SultanShadow/Bi_DIR_AMP_5G/netgen/user_analog_project_wrapper.spice

* NGSPICE file created from user_analog_project_wrapper.ext - technology: sky130A

.subckt sky130_fd_pr__pfet_01v8_lvt_4QC8GG a_n93_n5000# w_n231_n5219# a_n35_n5097#
+ a_35_n5000# VSUBS
X0 a_35_n5000# a_n35_n5097# a_n93_n5000# w_n231_n5219# sky130_fd_pr__pfet_01v8_lvt ad=0p pd=0u as=0p ps=0u w=5e+07u l=350000u
.ends

.subckt sky130_fd_pr__nfet_01v8_lvt_8K7EBA a_n93_n2000# w_n221_n2200# a_35_n2000#
+ a_n35_n2088#
X0 a_35_n2000# a_n35_n2088# a_n93_n2000# w_n221_n2200# sky130_fd_pr__nfet_01v8_lvt ad=0p pd=0u as=0p ps=0u w=2e+07u l=350000u
.ends

.subckt Comparator_jafar VIN- VOUT VSS VINp
Xsky130_fd_pr__pfet_01v8_lvt_4QC8GG_0 VIN- VIN- a_3872_2262# m1_7222_1296# VSS sky130_fd_pr__pfet_01v8_lvt_4QC8GG
Xsky130_fd_pr__pfet_01v8_lvt_4QC8GG_1 VIN- VIN- m1_7222_1296# a_3872_2262# VSS sky130_fd_pr__pfet_01v8_lvt_4QC8GG
Xsky130_fd_pr__pfet_01v8_lvt_4QC8GG_2 VOUT VIN- m1_7222_1296# VINp VSS sky130_fd_pr__pfet_01v8_lvt_4QC8GG
Xsky130_fd_pr__nfet_01v8_lvt_8K7EBA_0 m1_6338_1372# VSS VSS VIN- sky130_fd_pr__nfet_01v8_lvt_8K7EBA
Xsky130_fd_pr__nfet_01v8_lvt_8K7EBA_1 m1_6338_1372# VSS m1_7222_1296# VINp sky130_fd_pr__nfet_01v8_lvt_8K7EBA
Xsky130_fd_pr__nfet_01v8_lvt_8K7EBA_2 a_3872_2262# VSS m1_6338_1372# VIN- sky130_fd_pr__nfet_01v8_lvt_8K7EBA
Xsky130_fd_pr__nfet_01v8_lvt_8K7EBA_3 m1_10602_1432# VSS VOUT VINp sky130_fd_pr__nfet_01v8_lvt_8K7EBA
Xsky130_fd_pr__nfet_01v8_lvt_8K7EBA_4 m1_10602_1432# VSS VSS VIN- sky130_fd_pr__nfet_01v8_lvt_8K7EBA
.ends

.subckt sky130_fd_pr__cap_mim_m3_1_ZP6U3S c1_3269_n47100# c1_41183_n47100# m3_22126_n47200#
+ m3_n15788_n47200# m3_n34745_n47200# m3_n47383_n47200# m3_9488_n47200# c1_22226_n47100#
+ c1_n22007_n47100# c1_n40964_n47100# m3_n28426_n47200# m3_34764_n47200# c1_n9369_n47100#
+ c1_9588_n47100# m3_n41064_n47200# c1_n3050_n47100# m3_3169_n47200# c1_34864_n47100#
+ c1_n15688_n47100# c1_n34645_n47100# c1_n47283_n47100# m3_28445_n47200# m3_15807_n47200#
+ m3_n9469_n47200# m3_41083_n47200# m3_n22107_n47200# c1_28545_n47100# c1_15907_n47100#
+ c1_n28326_n47100# m3_n3150_n47200# VSUBS
X0 c1_n47283_n47100# m3_n47383_n47200# sky130_fd_pr__cap_mim_m3_1 l=3e+07u w=3e+07u
X1 c1_41183_n47100# m3_41083_n47200# sky130_fd_pr__cap_mim_m3_1 l=3e+07u w=3e+07u
X2 c1_n40964_n47100# m3_n41064_n47200# sky130_fd_pr__cap_mim_m3_1 l=3e+07u w=3e+07u
X3 c1_41183_n47100# m3_41083_n47200# sky130_fd_pr__cap_mim_m3_1 l=3e+07u w=3e+07u
X4 c1_28545_n47100# m3_28445_n47200# sky130_fd_pr__cap_mim_m3_1 l=3e+07u w=3e+07u
X5 c1_n22007_n47100# m3_n22107_n47200# sky130_fd_pr__cap_mim_m3_1 l=3e+07u w=3e+07u
X6 c1_34864_n47100# m3_34764_n47200# sky130_fd_pr__cap_mim_m3_1 l=3e+07u w=3e+07u
X7 c1_n40964_n47100# m3_n41064_n47200# sky130_fd_pr__cap_mim_m3_1 l=3e+07u w=3e+07u
X8 c1_n47283_n47100# m3_n47383_n47200# sky130_fd_pr__cap_mim_m3_1 l=3e+07u w=3e+07u
X9 c1_34864_n47100# m3_34764_n47200# sky130_fd_pr__cap_mim_m3_1 l=3e+07u w=3e+07u
X10 c1_n15688_n47100# m3_n15788_n47200# sky130_fd_pr__cap_mim_m3_1 l=3e+07u w=3e+07u
X11 c1_n34645_n47100# m3_n34745_n47200# sky130_fd_pr__cap_mim_m3_1 l=3e+07u w=3e+07u
X12 c1_15907_n47100# m3_15807_n47200# sky130_fd_pr__cap_mim_m3_1 l=3e+07u w=3e+07u
X13 c1_n15688_n47100# m3_n15788_n47200# sky130_fd_pr__cap_mim_m3_1 l=3e+07u w=3e+07u
X14 c1_n40964_n47100# m3_n41064_n47200# sky130_fd_pr__cap_mim_m3_1 l=3e+07u w=3e+07u
X15 c1_9588_n47100# m3_9488_n47200# sky130_fd_pr__cap_mim_m3_1 l=3e+07u w=3e+07u
X16 c1_n34645_n47100# m3_n34745_n47200# sky130_fd_pr__cap_mim_m3_1 l=3e+07u w=3e+07u
X17 c1_15907_n47100# m3_15807_n47200# sky130_fd_pr__cap_mim_m3_1 l=3e+07u w=3e+07u
X18 c1_34864_n47100# m3_34764_n47200# sky130_fd_pr__cap_mim_m3_1 l=3e+07u w=3e+07u
X19 c1_n3050_n47100# m3_n3150_n47200# sky130_fd_pr__cap_mim_m3_1 l=3e+07u w=3e+07u
X20 c1_n47283_n47100# m3_n47383_n47200# sky130_fd_pr__cap_mim_m3_1 l=3e+07u w=3e+07u
X21 c1_22226_n47100# m3_22126_n47200# sky130_fd_pr__cap_mim_m3_1 l=3e+07u w=3e+07u
X22 c1_41183_n47100# m3_41083_n47200# sky130_fd_pr__cap_mim_m3_1 l=3e+07u w=3e+07u
X23 c1_9588_n47100# m3_9488_n47200# sky130_fd_pr__cap_mim_m3_1 l=3e+07u w=3e+07u
X24 c1_n34645_n47100# m3_n34745_n47200# sky130_fd_pr__cap_mim_m3_1 l=3e+07u w=3e+07u
X25 c1_n15688_n47100# m3_n15788_n47200# sky130_fd_pr__cap_mim_m3_1 l=3e+07u w=3e+07u
X26 c1_28545_n47100# m3_28445_n47200# sky130_fd_pr__cap_mim_m3_1 l=3e+07u w=3e+07u
X27 c1_n34645_n47100# m3_n34745_n47200# sky130_fd_pr__cap_mim_m3_1 l=3e+07u w=3e+07u
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
Xsky130_fd_pr__pfet_01v8_lvt_4QDPGG_0[14] B G S D sky130_fd_pr__pfet_01v8_lvt_4QDPGG_0[14]/VSUBS
+ sky130_fd_pr__pfet_01v8_lvt_4QDPGG
Xsky130_fd_pr__pfet_01v8_lvt_4QDPGG_0[15] B G S D sky130_fd_pr__pfet_01v8_lvt_4QDPGG_0[15]/VSUBS
+ sky130_fd_pr__pfet_01v8_lvt_4QDPGG
Xsky130_fd_pr__pfet_01v8_lvt_4QDPGG_0[16] B G S D sky130_fd_pr__pfet_01v8_lvt_4QDPGG_0[16]/VSUBS
+ sky130_fd_pr__pfet_01v8_lvt_4QDPGG
Xsky130_fd_pr__pfet_01v8_lvt_4QDPGG_0[17] B G S D sky130_fd_pr__pfet_01v8_lvt_4QDPGG_0[17]/VSUBS
+ sky130_fd_pr__pfet_01v8_lvt_4QDPGG
Xsky130_fd_pr__pfet_01v8_lvt_4QDPGG_0[18] B G S D VSUBS sky130_fd_pr__pfet_01v8_lvt_4QDPGG
Xsky130_fd_pr__pfet_01v8_lvt_4QDPGG_0[19] B G S D sky130_fd_pr__pfet_01v8_lvt_4QDPGG_0[19]/VSUBS
+ sky130_fd_pr__pfet_01v8_lvt_4QDPGG
.ends

.subckt pmos40 pmos20_0[1]/S pmos20_0[1]/G pmos20_0[1]/B pmos20_0[1]/D VSUBS
Xpmos20_0[0] pmos20_0[1]/D pmos20_0[1]/S pmos20_0[1]/B pmos20_0[1]/G VSUBS pmos20
Xpmos20_0[1] pmos20_0[1]/D pmos20_0[1]/S pmos20_0[1]/B pmos20_0[1]/G pmos20_0[1]/VSUBS
+ pmos20
.ends

.subckt sky130_fd_pr__nfet_01v8_lvt_BPY4AF w_n221_n8200# a_35_n8000# a_n35_n8088#
+ a_n93_n8000#
X0 a_35_n8000# a_n35_n8088# a_n93_n8000# w_n221_n8200# sky130_fd_pr__nfet_01v8_lvt ad=0p pd=0u as=0p ps=0u w=8e+07u l=350000u
.ends

.subckt nmos20 B G D S VSUBS
Xsky130_fd_pr__nfet_01v8_lvt_BPY4AF_0[0] sky130_fd_pr__nfet_01v8_lvt_BPY4AF_0[0]/w_n221_n8200#
+ S G D sky130_fd_pr__nfet_01v8_lvt_BPY4AF
Xsky130_fd_pr__nfet_01v8_lvt_BPY4AF_0[1] sky130_fd_pr__nfet_01v8_lvt_BPY4AF_0[1]/w_n221_n8200#
+ S G D sky130_fd_pr__nfet_01v8_lvt_BPY4AF
Xsky130_fd_pr__nfet_01v8_lvt_BPY4AF_0[2] B S G D sky130_fd_pr__nfet_01v8_lvt_BPY4AF
Xsky130_fd_pr__nfet_01v8_lvt_BPY4AF_0[3] sky130_fd_pr__nfet_01v8_lvt_BPY4AF_0[3]/w_n221_n8200#
+ S G D sky130_fd_pr__nfet_01v8_lvt_BPY4AF
Xsky130_fd_pr__nfet_01v8_lvt_BPY4AF_0[4] sky130_fd_pr__nfet_01v8_lvt_BPY4AF_0[4]/w_n221_n8200#
+ S G D sky130_fd_pr__nfet_01v8_lvt_BPY4AF
Xsky130_fd_pr__nfet_01v8_lvt_BPY4AF_0[5] B S G D sky130_fd_pr__nfet_01v8_lvt_BPY4AF
Xsky130_fd_pr__nfet_01v8_lvt_BPY4AF_0[6] sky130_fd_pr__nfet_01v8_lvt_BPY4AF_0[6]/w_n221_n8200#
+ S G D sky130_fd_pr__nfet_01v8_lvt_BPY4AF
Xsky130_fd_pr__nfet_01v8_lvt_BPY4AF_0[7] sky130_fd_pr__nfet_01v8_lvt_BPY4AF_0[7]/w_n221_n8200#
+ S G D sky130_fd_pr__nfet_01v8_lvt_BPY4AF
Xsky130_fd_pr__nfet_01v8_lvt_BPY4AF_0[8] B S G D sky130_fd_pr__nfet_01v8_lvt_BPY4AF
Xsky130_fd_pr__nfet_01v8_lvt_BPY4AF_0[9] sky130_fd_pr__nfet_01v8_lvt_BPY4AF_0[9]/w_n221_n8200#
+ S G D sky130_fd_pr__nfet_01v8_lvt_BPY4AF
Xsky130_fd_pr__nfet_01v8_lvt_BPY4AF_0[10] sky130_fd_pr__nfet_01v8_lvt_BPY4AF_0[10]/w_n221_n8200#
+ S G D sky130_fd_pr__nfet_01v8_lvt_BPY4AF
Xsky130_fd_pr__nfet_01v8_lvt_BPY4AF_0[11] B S G D sky130_fd_pr__nfet_01v8_lvt_BPY4AF
Xsky130_fd_pr__nfet_01v8_lvt_BPY4AF_0[12] sky130_fd_pr__nfet_01v8_lvt_BPY4AF_0[12]/w_n221_n8200#
+ S G D sky130_fd_pr__nfet_01v8_lvt_BPY4AF
Xsky130_fd_pr__nfet_01v8_lvt_BPY4AF_0[13] sky130_fd_pr__nfet_01v8_lvt_BPY4AF_0[13]/w_n221_n8200#
+ S G D sky130_fd_pr__nfet_01v8_lvt_BPY4AF
Xsky130_fd_pr__nfet_01v8_lvt_BPY4AF_0[14] sky130_fd_pr__nfet_01v8_lvt_BPY4AF_0[14]/w_n221_n8200#
+ S G D sky130_fd_pr__nfet_01v8_lvt_BPY4AF
Xsky130_fd_pr__nfet_01v8_lvt_BPY4AF_0[15] B S G D sky130_fd_pr__nfet_01v8_lvt_BPY4AF
Xsky130_fd_pr__nfet_01v8_lvt_BPY4AF_0[16] sky130_fd_pr__nfet_01v8_lvt_BPY4AF_0[16]/w_n221_n8200#
+ S G D sky130_fd_pr__nfet_01v8_lvt_BPY4AF
Xsky130_fd_pr__nfet_01v8_lvt_BPY4AF_0[17] sky130_fd_pr__nfet_01v8_lvt_BPY4AF_0[17]/w_n221_n8200#
+ S G D sky130_fd_pr__nfet_01v8_lvt_BPY4AF
Xsky130_fd_pr__nfet_01v8_lvt_BPY4AF_0[18] B S G D sky130_fd_pr__nfet_01v8_lvt_BPY4AF
Xsky130_fd_pr__nfet_01v8_lvt_BPY4AF_0[19] B S G D sky130_fd_pr__nfet_01v8_lvt_BPY4AF
.ends

.subckt recitifer_layout VIN1 VSS VINN VINP VSUBS
Xpmos20_0 VIN1 VINP VINP VINN VSUBS pmos20
Xpmos20_1 VIN1 VINN VINN VINP VSUBS pmos20
Xnmos20_0 VSS VINP VINN VSS VSUBS nmos20
Xnmos20_1 VSS VINN VINP VSS VSUBS nmos20
.ends

.subckt RX_layout VOUT_C VSS VIN1 VIN2 pmos40_0/pmos20_0[1]/D recitifer_layout_0/VINP
+ recitifer_layout_0/VINN VSUBS
Xcap225_layout_0 VIN2 VSS VSUBS cap225_layout
Xpmos40_0 VIN2 VOUT_C VIN2 pmos40_0/pmos20_0[1]/D VSUBS pmos40
Xrecitifer_layout_0 VIN1 VSS recitifer_layout_0/VINN recitifer_layout_0/VINP VSUBS
+ recitifer_layout
Xpmos40_1 VIN1 VOUT_C VIN2 VIN2 VSUBS pmos40
.ends

.subckt FINAL RX_layout_0/recitifer_layout_0/VINP RX_layout_0/pmos40_0/pmos20_0[1]/D
+ RX_layout_0/recitifer_layout_0/VINN RX_layout_0/VIN2 VSUBS
XComparator_jafar_0 RX_layout_0/VIN1 RX_layout_0/VOUT_C VSUBS RX_layout_0/VIN2 Comparator_jafar
XRX_layout_0 RX_layout_0/VOUT_C VSUBS RX_layout_0/VIN1 RX_layout_0/VIN2 RX_layout_0/pmos40_0/pmos20_0[1]/D
+ RX_layout_0/recitifer_layout_0/VINP RX_layout_0/recitifer_layout_0/VINN VSUBS RX_layout
.ends

.subckt sky130_fd_pr__cap_mim_m3_1_LQCLLG m3_n12628_n12550# c1_110_n12450# c1_n6209_n12450#
+ m3_6329_n12550# c1_n12528_n12450# m3_10_n12550# c1_6429_n12450# m3_n6309_n12550#
+ VSUBS
X0 c1_6429_n12450# m3_6329_n12550# sky130_fd_pr__cap_mim_m3_1 l=3e+07u w=3e+07u
X1 c1_n6209_n12450# m3_n6309_n12550# sky130_fd_pr__cap_mim_m3_1 l=3e+07u w=3e+07u
X2 c1_110_n12450# m3_10_n12550# sky130_fd_pr__cap_mim_m3_1 l=3e+07u w=3e+07u
X3 c1_6429_n12450# m3_6329_n12550# sky130_fd_pr__cap_mim_m3_1 l=3e+07u w=3e+07u
X4 c1_110_n12450# m3_10_n12550# sky130_fd_pr__cap_mim_m3_1 l=3e+07u w=3e+07u
X5 c1_n12528_n12450# m3_n12628_n12550# sky130_fd_pr__cap_mim_m3_1 l=3e+07u w=3e+07u
X6 c1_n6209_n12450# m3_n6309_n12550# sky130_fd_pr__cap_mim_m3_1 l=3e+07u w=3e+07u
X7 c1_6429_n12450# m3_6329_n12550# sky130_fd_pr__cap_mim_m3_1 l=3e+07u w=3e+07u
X8 c1_110_n12450# m3_10_n12550# sky130_fd_pr__cap_mim_m3_1 l=3e+07u w=3e+07u
X9 c1_n12528_n12450# m3_n12628_n12550# sky130_fd_pr__cap_mim_m3_1 l=3e+07u w=3e+07u
X10 c1_n6209_n12450# m3_n6309_n12550# sky130_fd_pr__cap_mim_m3_1 l=3e+07u w=3e+07u
X11 c1_n12528_n12450# m3_n12628_n12550# sky130_fd_pr__cap_mim_m3_1 l=3e+07u w=3e+07u
X12 c1_n12528_n12450# m3_n12628_n12550# sky130_fd_pr__cap_mim_m3_1 l=3e+07u w=3e+07u
X13 c1_n6209_n12450# m3_n6309_n12550# sky130_fd_pr__cap_mim_m3_1 l=3e+07u w=3e+07u
X14 c1_110_n12450# m3_10_n12550# sky130_fd_pr__cap_mim_m3_1 l=3e+07u w=3e+07u
X15 c1_6429_n12450# m3_6329_n12550# sky130_fd_pr__cap_mim_m3_1 l=3e+07u w=3e+07u
.ends

.subckt cap_30_layout VIN VOUT VSUBS
Xsky130_fd_pr__cap_mim_m3_1_LQCLLG_0 VOUT VIN VIN VOUT VIN VOUT VIN VOUT VSUBS sky130_fd_pr__cap_mim_m3_1_LQCLLG
.ends

.subckt FINAL_without_ind VINN VINP VSUBS FINAL_0/RX_layout_0/pmos40_0/pmos20_0[1]/D
+ FINAL_0/RX_layout_0/VIN2
XFINAL_0 VINP FINAL_0/RX_layout_0/pmos40_0/pmos20_0[1]/D VINN FINAL_0/RX_layout_0/VIN2
+ VSUBS FINAL
Xcap_30_layout_0 VINP VINN VSUBS cap_30_layout
.ends
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
