SultanShadow/Bi_DIR_AMP_5G/(commit log)

2021-10-22 Project Submission
    [CompleteAMP.sch, Forward_AMP.sch, LNA.sch, LNA_TRANS.sch, PICO_BIAS.sch, Switch_Characterization.sch, Switch_Characterization2.sch, Top_PostLayout.sch]
2021-11-24 Caravel update
    [pin_order.cfg]
