SultanShadow/Bi_DIR_AMP_5G/(notices)

Notices in the files:
README.md:
License: Apache 2.0
